arushgupta2007/esp_home_control/images/Things_Required_And_Final_Result.jpg

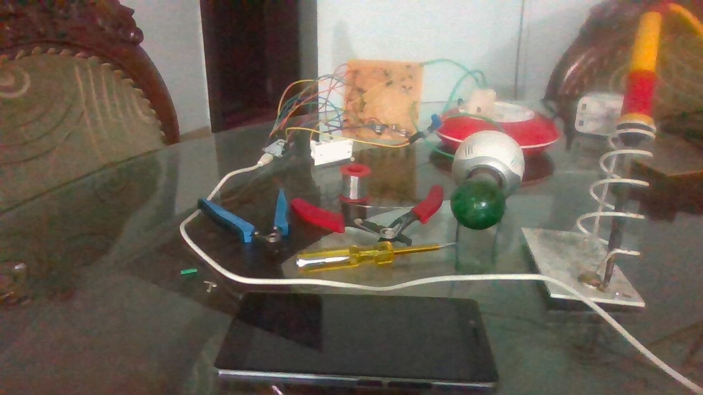
images/Things_Required_And_Final_Result.jpg
